Axolord/AlarmClockGen1/png/photo5339407668151953798.jpg

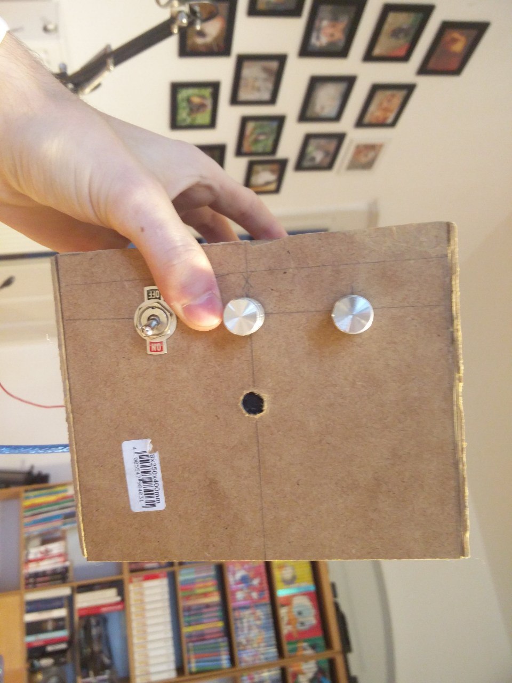
png/photo5339407668151953798.jpg
