Axolord/AlarmClockGen1/png/photo5339407668151953804.jpg

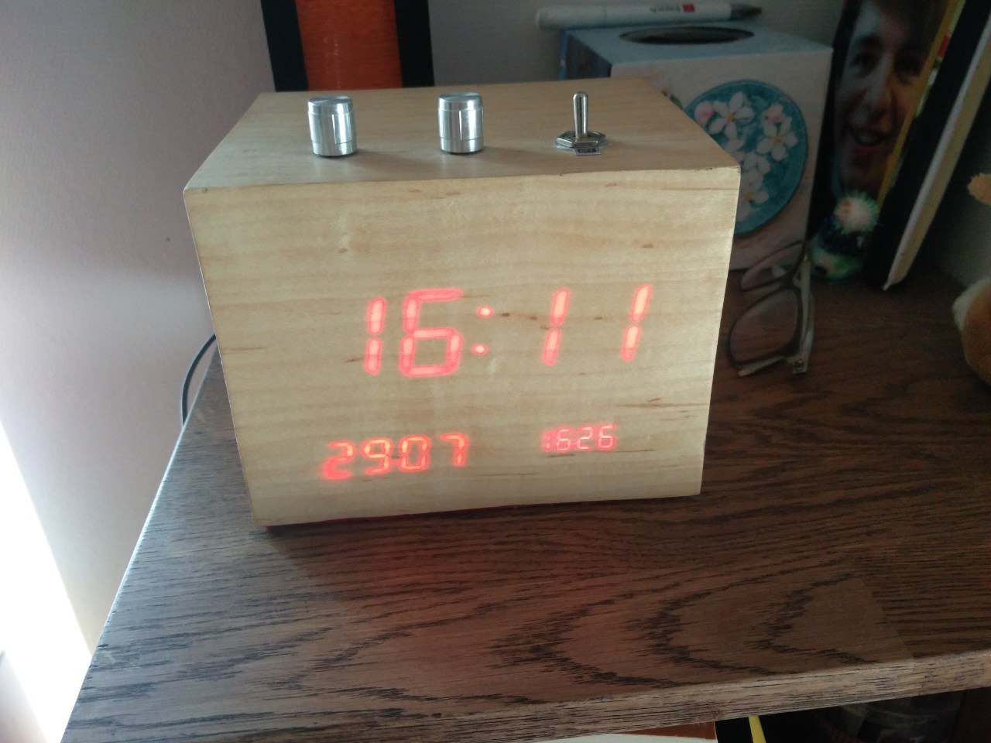
png/photo5339407668151953804.jpg
