Axolord/AlarmClockGen1/png/photo5339407668151953796.jpg

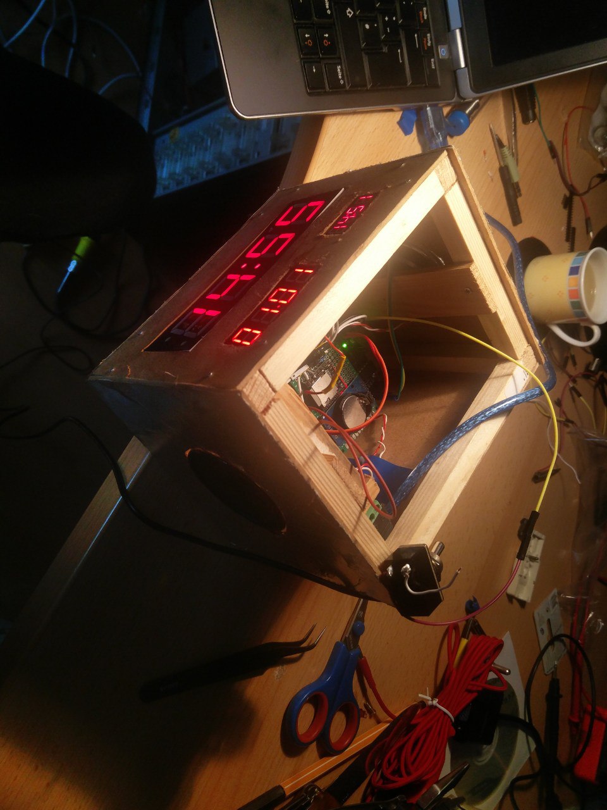
png/photo5339407668151953796.jpg
