Axolord/AlarmClockGen1/png/photo5339407668151953797.jpg

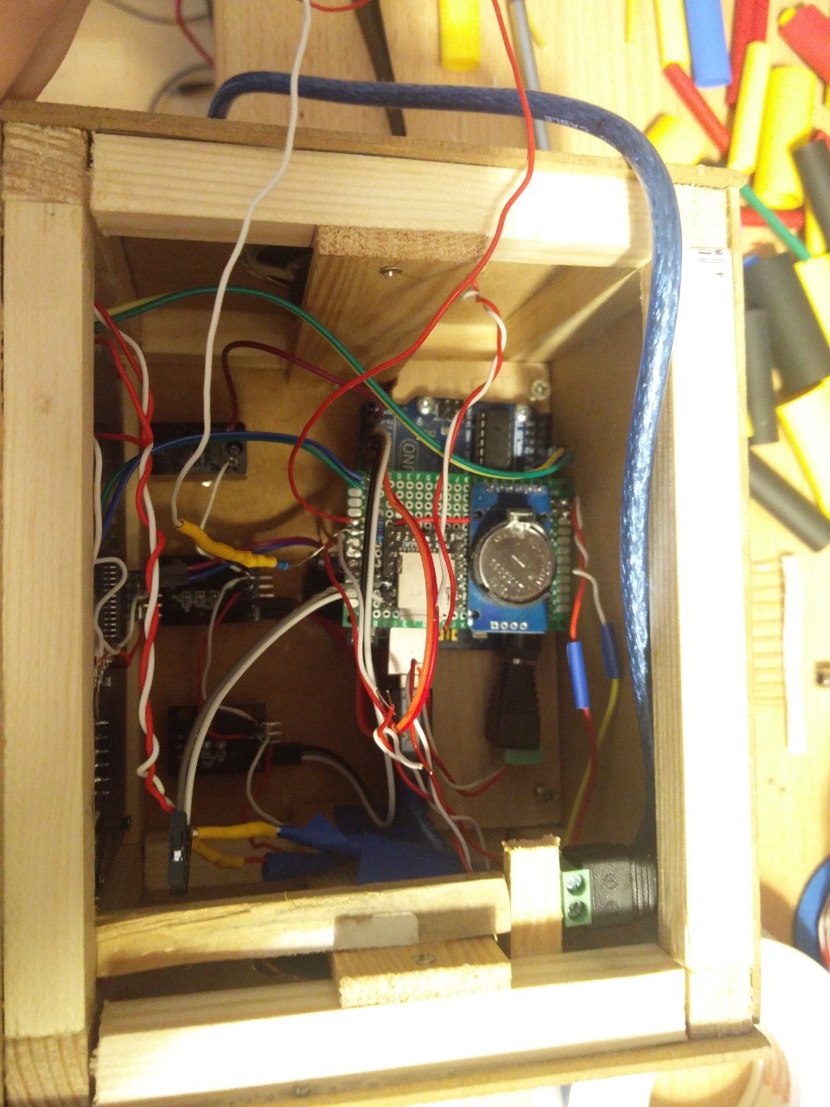
png/photo5339407668151953797.jpg
