Axolord/AlarmClockGen1/png/photo5339407668151953799.jpg

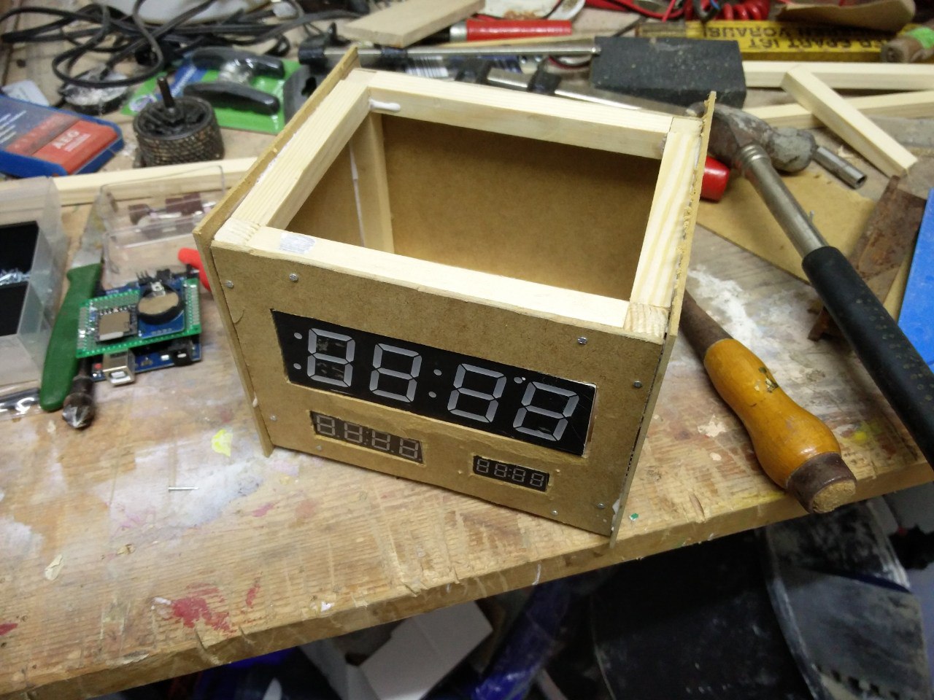
png/photo5339407668151953799.jpg
